pesalaG/Coal-miner-Protector/PRELIMINARY enclosure/solid/screeshots/Screenshot 2023-06-15 015323.png

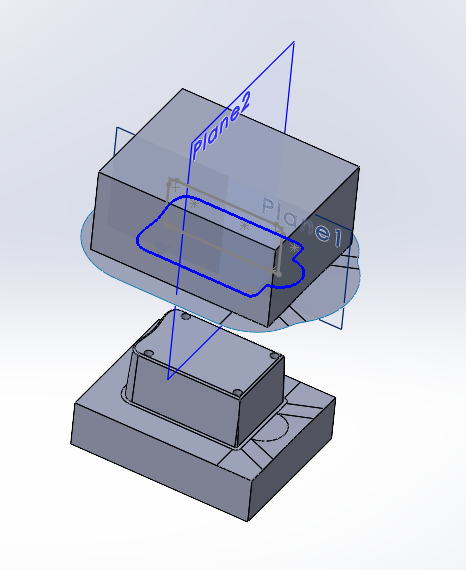
PRELIMINARY enclosure/solid/screeshots/Screenshot 2023-06-15 015323.png
