pesalaG/Coal-miner-Protector/app/R.jpg

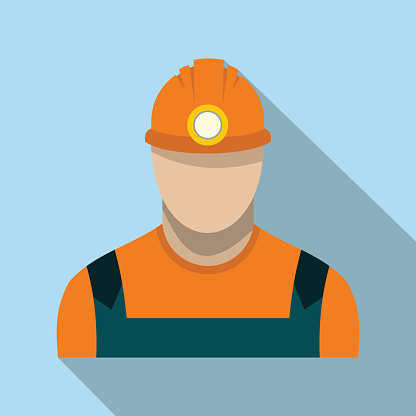
app/R.jpg
