pesalaG/Coal-miner-Protector/PRELIMINARY enclosure/solid/screeshots/Screenshot 2023-06-15 003643.png

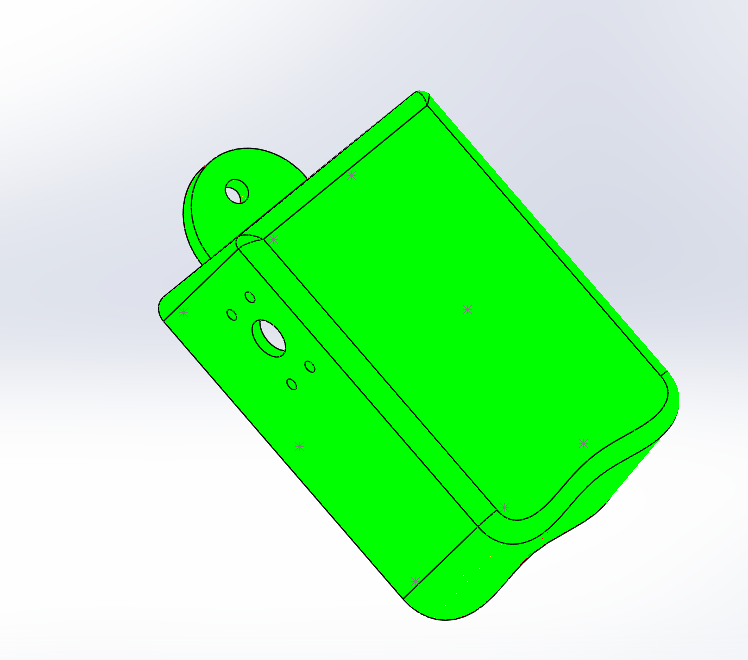
PRELIMINARY enclosure/solid/screeshots/Screenshot 2023-06-15 003643.png
