pesalaG/Coal-miner-Protector/PRELIMINARY enclosure/solid/screeshots/Screenshot 2023-06-15 012801.png

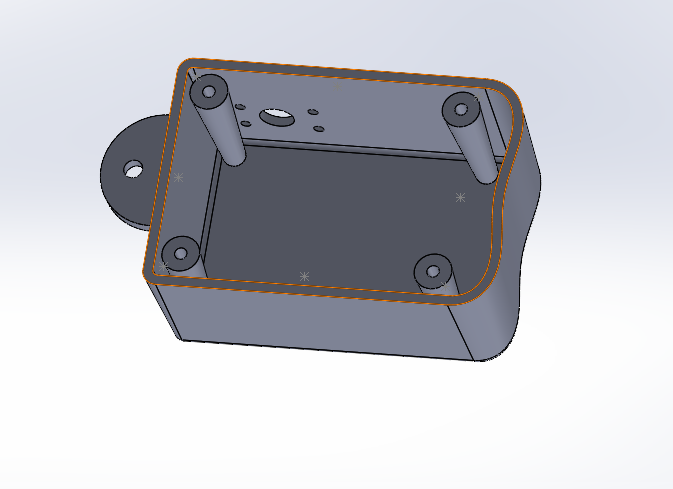
PRELIMINARY enclosure/solid/screeshots/Screenshot 2023-06-15 012801.png
