pesalaG/Coal-miner-Protector/PRELIMINARY enclosure/solid/Assem1.SLDASM

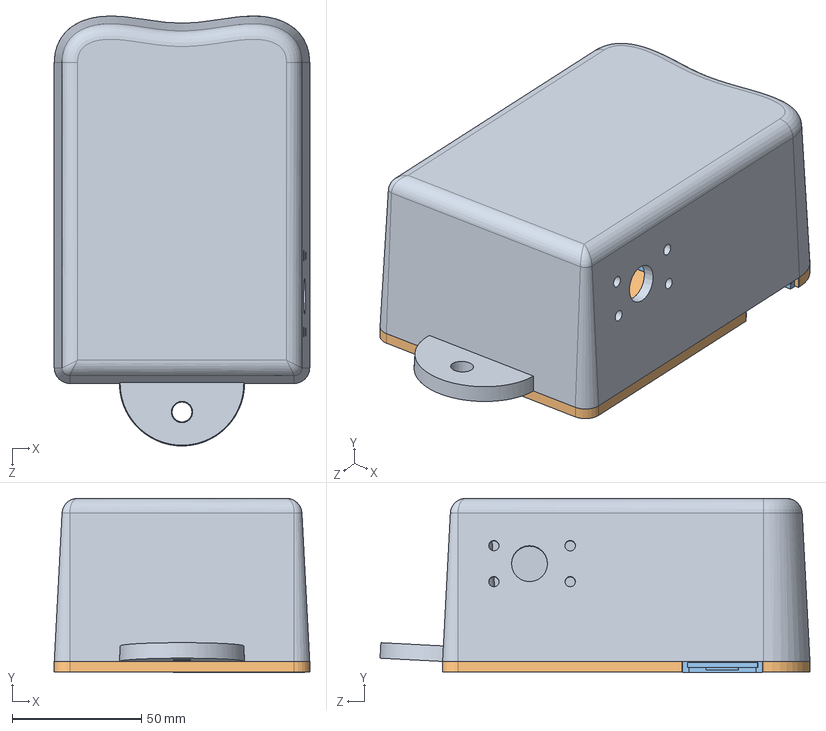
[picture p72: CAD file, 2023-08-26]
PRELIMINARY enclosure/solid/Assem1.SLDASM
98.7 x 67.3 x 166.1 mm
top_part
bottom
best_holder
