pesalaG/Coal-miner-Protector/enclosure/ORC-KIT_9V_Battery_Holder1.SLDPRT

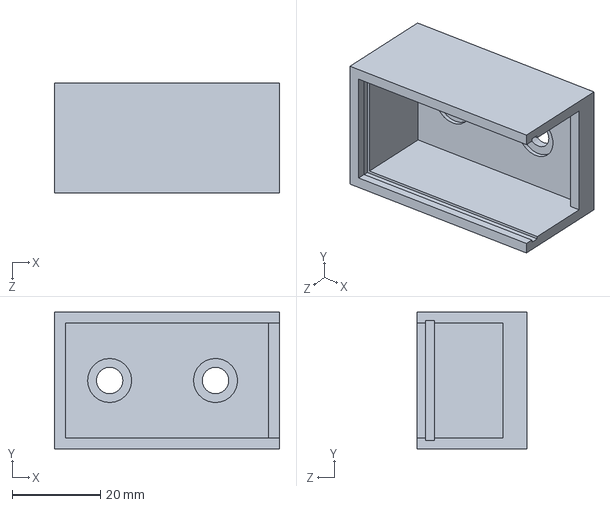
[picture p73: CAD file, 2023-08-26]
enclosure/ORC-KIT_9V_Battery_Holder1.SLDPRT
51.0 x 31.0 x 25.0 mm
