pesalaG/Coal-miner-Protector/PRELIMINARY enclosure/solid/bottom.SLDPRT

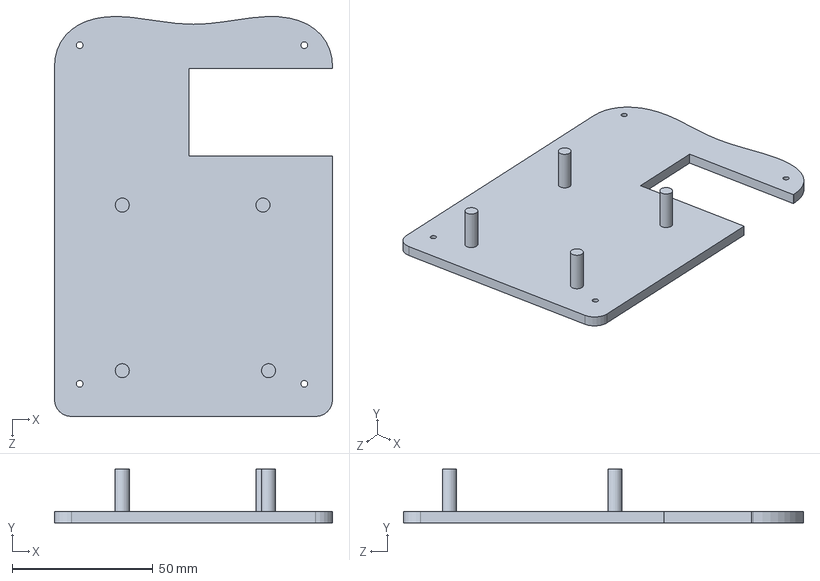
[picture p74: CAD file, 2023-08-26]
PRELIMINARY enclosure/solid/bottom.SLDPRT
98.7 x 19.0 x 141.9 mm
