pesalaG/Coal-miner-Protector/enclosure/miner1.SLDPRT

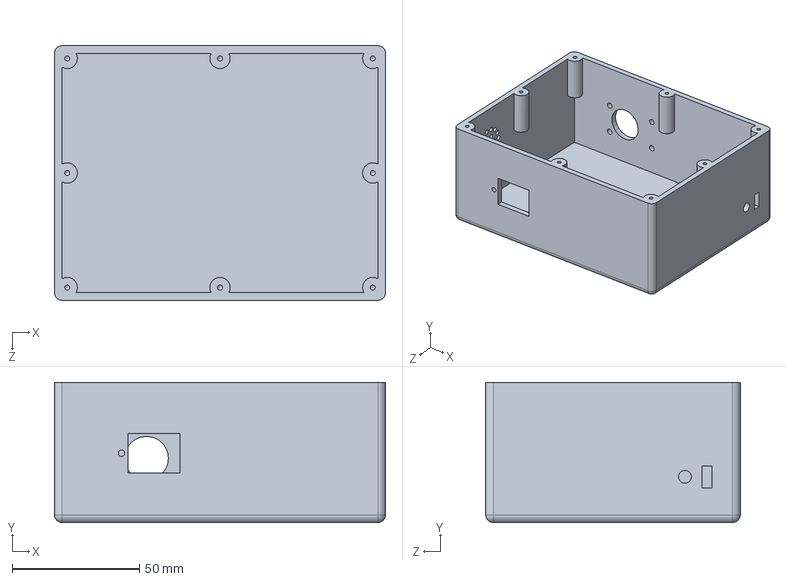
[picture p75: CAD file, 2023-08-26]
enclosure/miner1.SLDPRT
130.0 x 55.0 x 100.0 mm
