pesalaG/Coal-miner-Protector/enclosure/miner1_bottom.SLDPRT

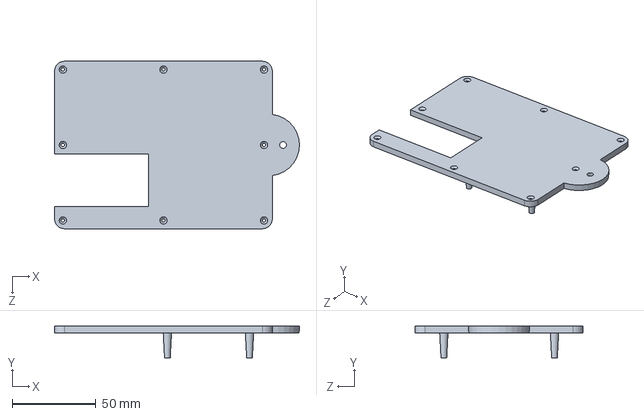
[picture p76: CAD file, 2023-08-26]
enclosure/miner1_bottom.SLDPRT
146.2 x 19.0 x 100.0 mm
