pesalaG/Coal-miner-Protector/enclosure/ORC-KIT_9V_Battery_Holder_lid.SLDPRT

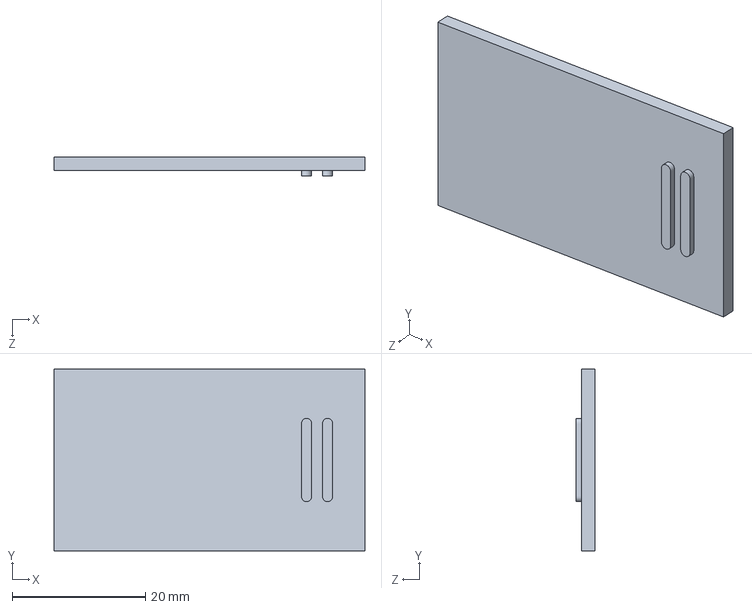
[picture p77: CAD file, 2023-08-26]
enclosure/ORC-KIT_9V_Battery_Holder_lid.SLDPRT
46.6 x 27.2 x 2.80 mm
