pesalaG/Coal-miner-Protector/pcb/schematic_design/miner_protector.pdf

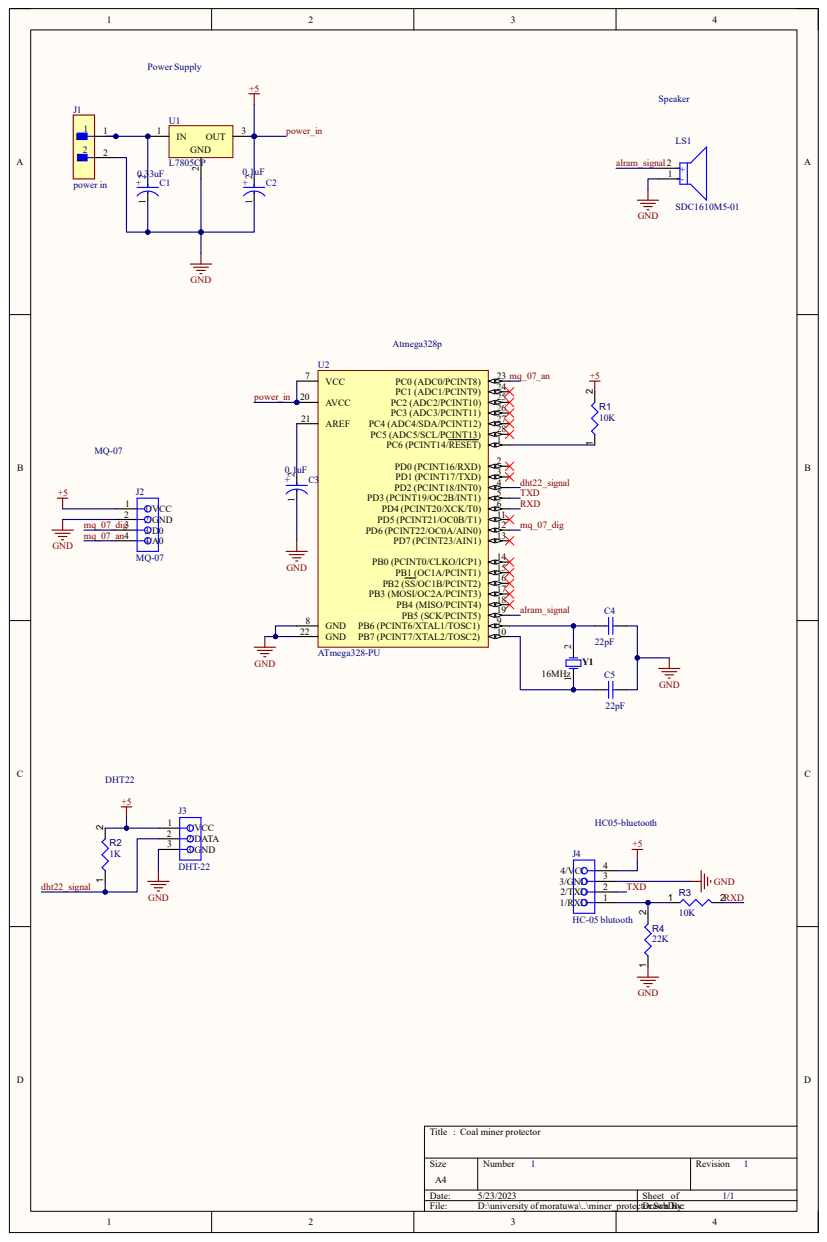
[picture p78: page 1]
