pesalaG/Coal-miner-Protector/PRELIMINARY enclosure/dcdc/dfdd.pdf

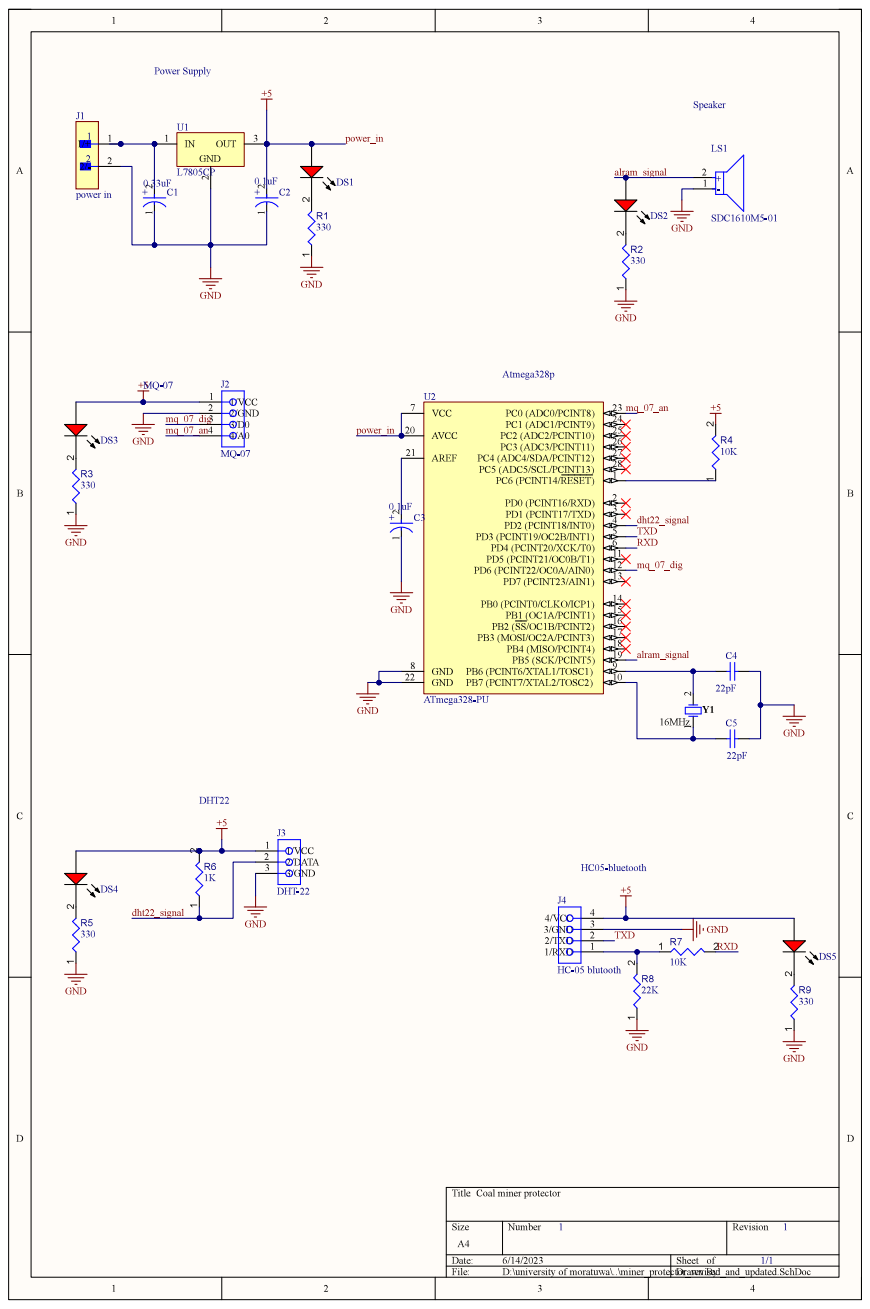
[picture p79: page 1]
