pesalaG/Coal-miner-Protector/(list of files, drawings)

Other design files:
pcb/miner_protector.PcbDoc
pcb/schematic_design/miner_protector.SchDoc
simulation/Project Backups/simulation_first [20230409, 16-58-20].pdsprj
simulation/Project Backups/simulation_first [20230409, 23-30-28].pdsprj
simulation/Project Backups/simulation_first [20230409, 23-30-34].pdsprj
simulation/Project Backups/simulation_first [20230410, 08-49-43].pdsprj
simulation/Project Backups/simulation_first [20230410, 17-31-54].pdsprj
simulation/Project Backups/simulation_first [20230411, 09-03-50].pdsprj
simulation/Project Backups/simulation_first [20230413, 14-27-59].pdsprj
simulation/Project Backups/simulation_first [20230418, 02-03-13].pdsprj
simulation/Project Backups/simulation_first [20230418, 12-27-42].pdsprj
simulation/Project Backups/simulation_first [20230418, 12-27-46].pdsprj
simulation/simulation_first.pdsprj
